rob-scape/quad-mod/schematic/Schematic_QuadMOD.pdf

# OLED Display

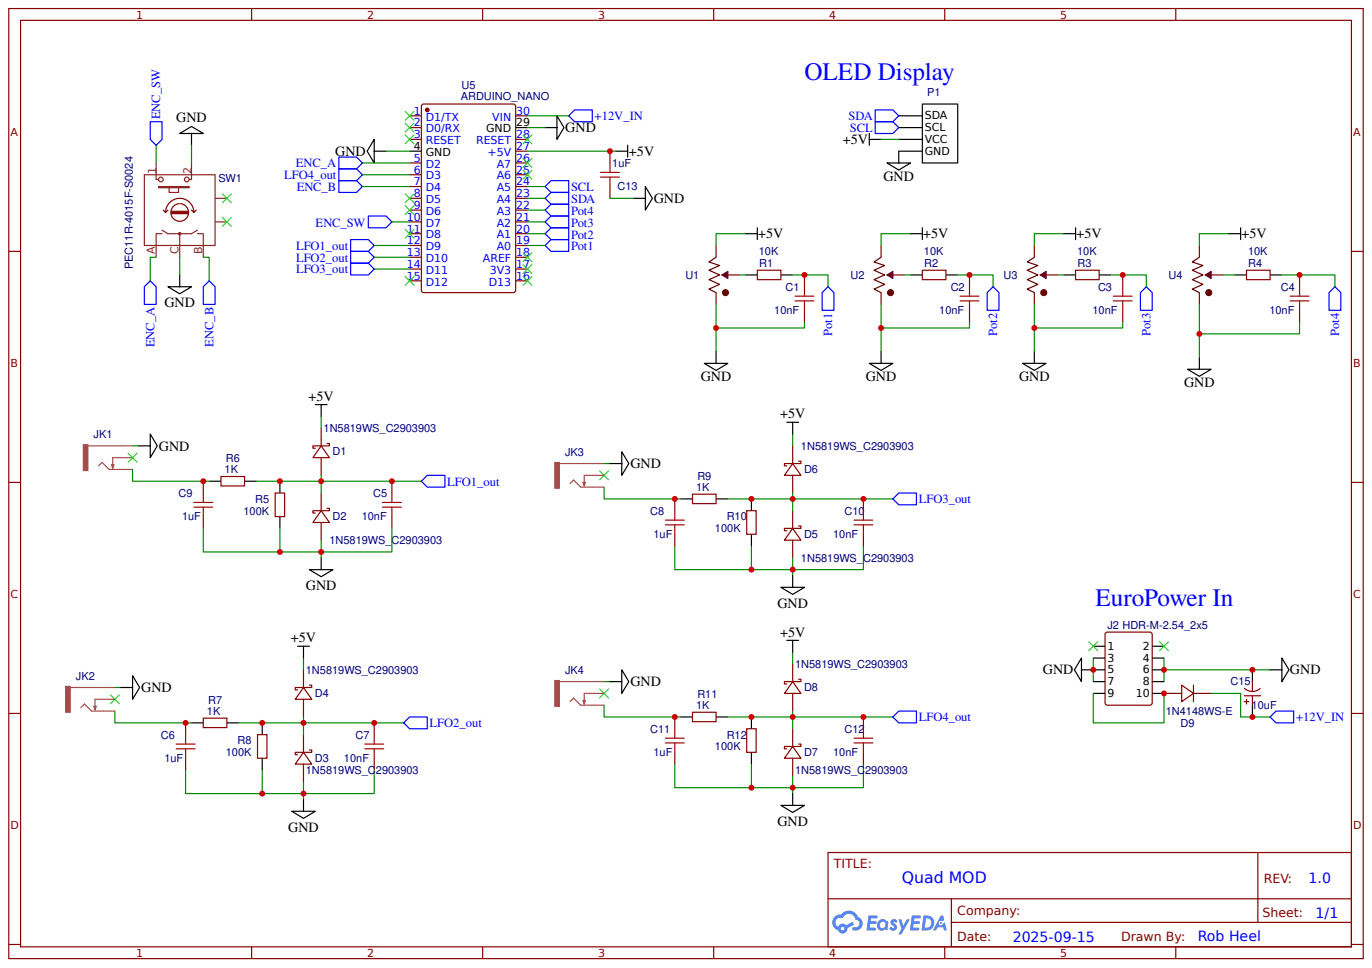
[picture p6: page 1]

Drawn By: Rob Heel
